scueper/Laser-engraving-with-Lasergrbl-and-and-Ender-3-S1-pro/BW-photo.jpg

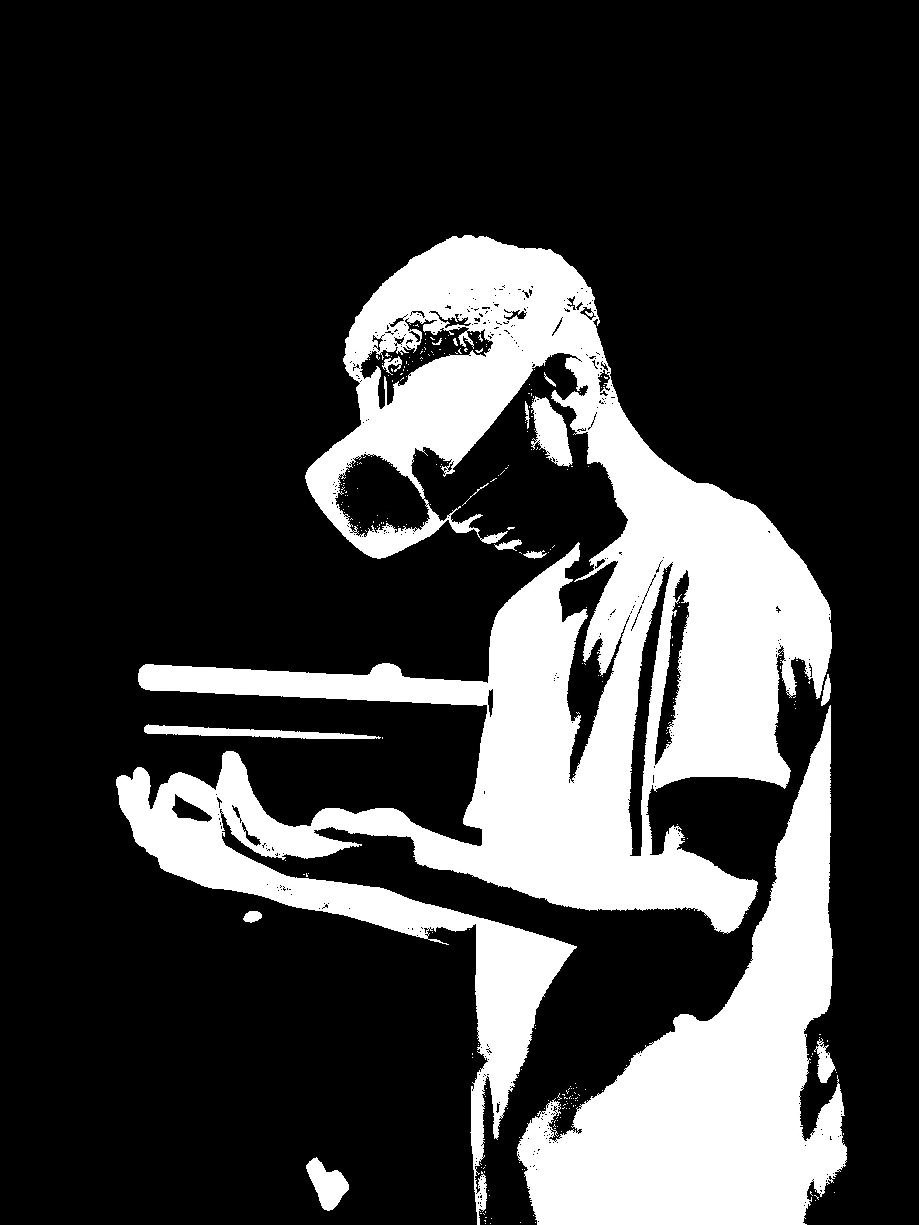
BW-photo.jpg
