scueper/Laser-engraving-with-Lasergrbl-and-and-Ender-3-S1-pro/Circuit_Diagram.JPG

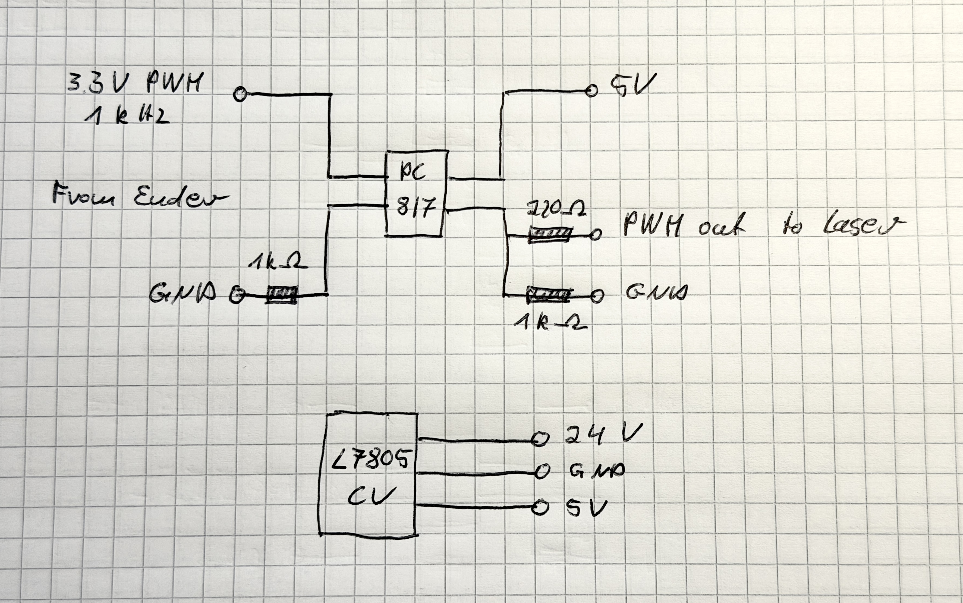
Circuit_Diagram.JPG
