scueper/Laser-engraving-with-Lasergrbl-and-and-Ender-3-S1-pro/Photo.JPG

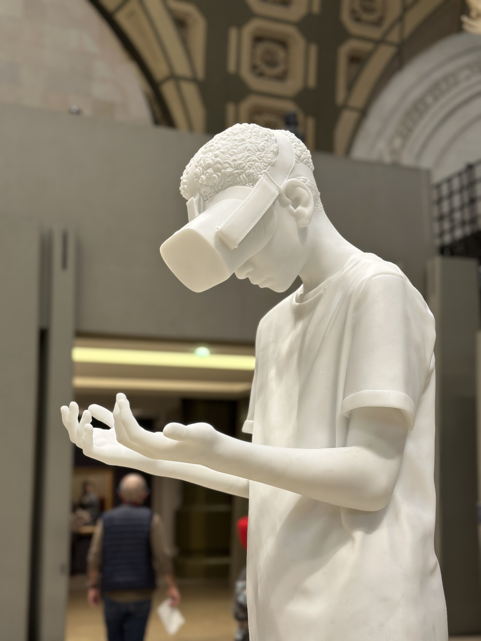
Photo.JPG
