scueper/Laser-engraving-with-Lasergrbl-and-and-Ender-3-S1-pro/Steal_24V.JPG

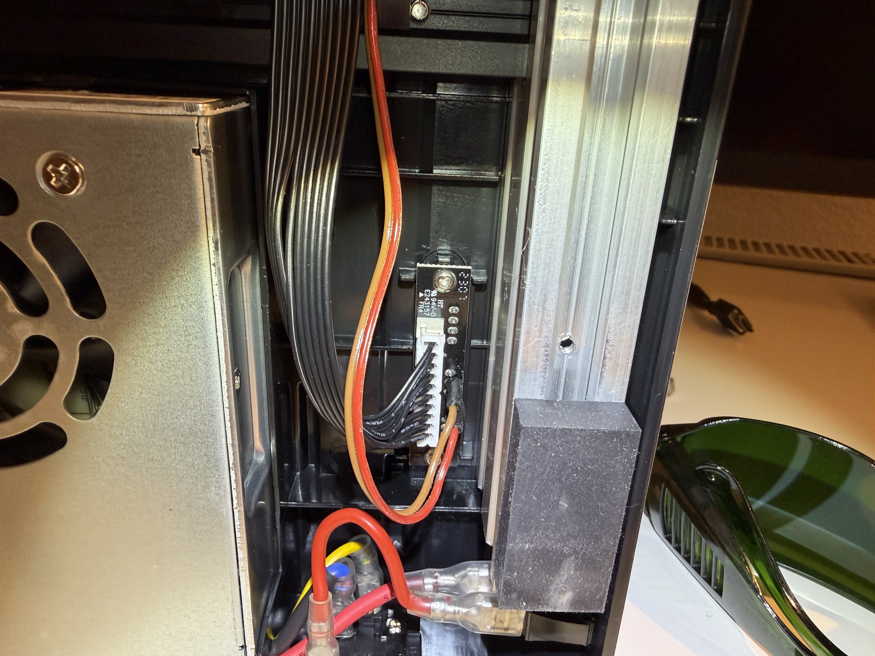
Steal_24V.JPG
