scueper/Laser-engraving-with-Lasergrbl-and-and-Ender-3-S1-pro/Breakout_Board.JPG

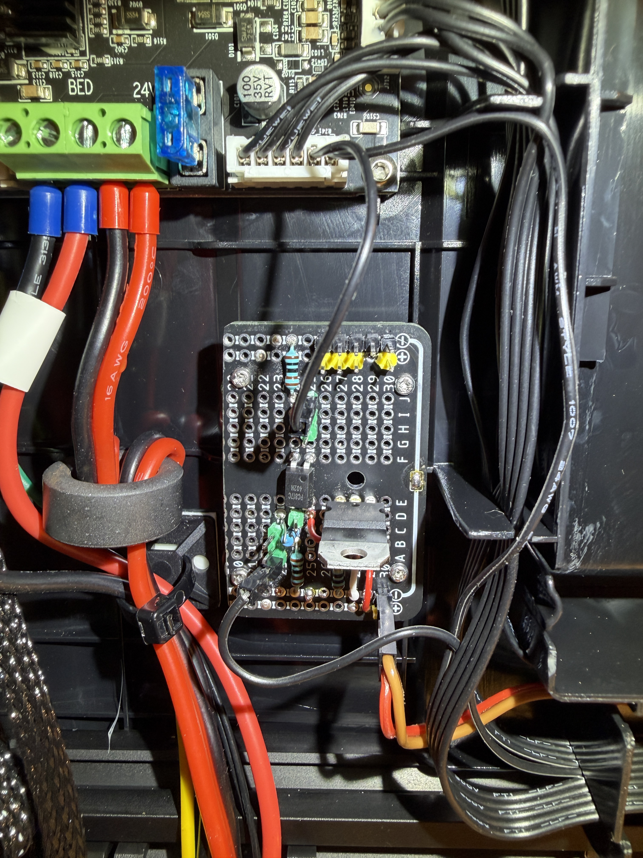
Breakout_Board.JPG
